wasyl07/skylark/buildroot-2025.02.15/board/freescale/imx6sxsdb/readme.txt

NXP i.MX6SX SDB board
---------------------

To build a minimal support for this board:

$ make imx6sx-sdb_defconfig
$ make

Buildroot prepares a bootable "sdcard.img" image in the output/images/
directory, ready to be flashed into the SD card:

$ sudo dd if=output/images/sdcard.img of=/dev/<sd-card-device>; sync

Then insert the SD card into the SD4 boot slot and boot the board.
