wasyl07/skylark/buildroot-2025.02.15/board/qemu/aarch64-virt/readme.txt

Run the emulation with:

  qemu-system-aarch64 -M virt -cpu cortex-a53 -nographic -smp 1 -kernel output/images/Image -append "rootwait root=/dev/vda console=ttyAMA0" -netdev user,id=eth0 -device virtio-net-device,netdev=eth0 -drive file=output/images/rootfs.ext4,if=none,format=raw,id=hd0 -device virtio-blk-device,drive=hd0 # qemu_aarch64_virt_defconfig

The login prompt will appear in the terminal that started Qemu.
