wasyl07/skylark/buildroot-2025.02.15/docs/manual/github_hash_mongrel2.png

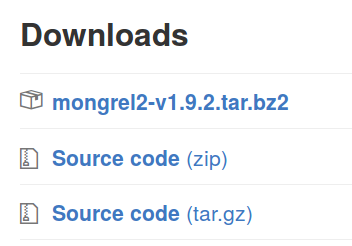
buildroot-2025.02.15/docs/manual/github_hash_mongrel2.png
