wasyl07/skylark/buildroot-2025.02.15/docs/website/images/buildroot-slides.png

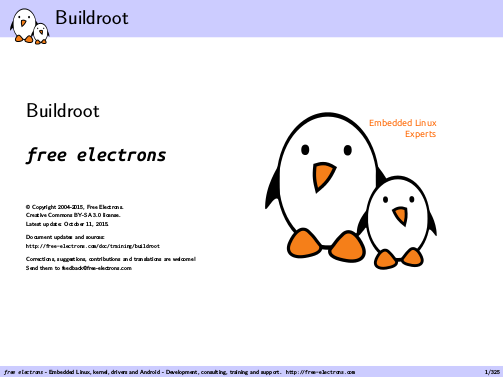
buildroot-2025.02.15/docs/website/images/buildroot-slides.png
