wasyl07/skylark/buildroot-2025.02.15/docs/website/images/menuconfig.png

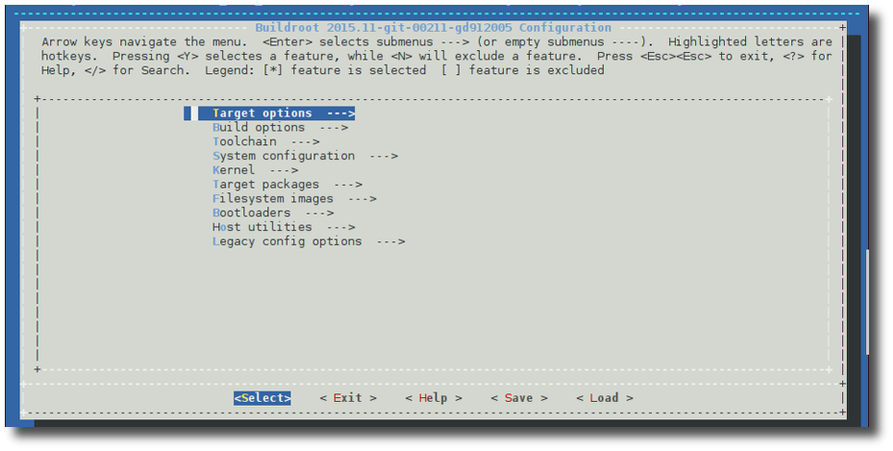
buildroot-2025.02.15/docs/website/images/menuconfig.png
