wasyl07/skylark/buildroot-2025.02.15/docs/website/images/nconfig.png

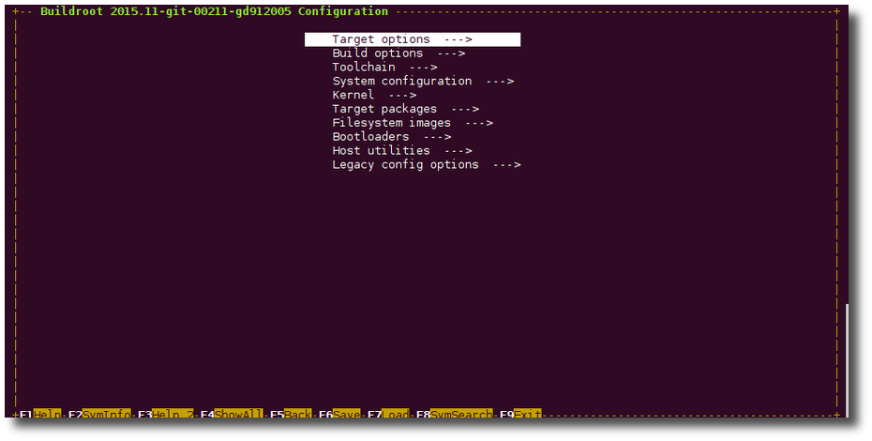
buildroot-2025.02.15/docs/website/images/nconfig.png
