wasyl07/skylark/BeagleBone-cape/BeagleBone-cape.kicad_pcb

## KiCad design BeagleBone-cape/BeagleBone-cape.kicad_pcb (2026-10-22)

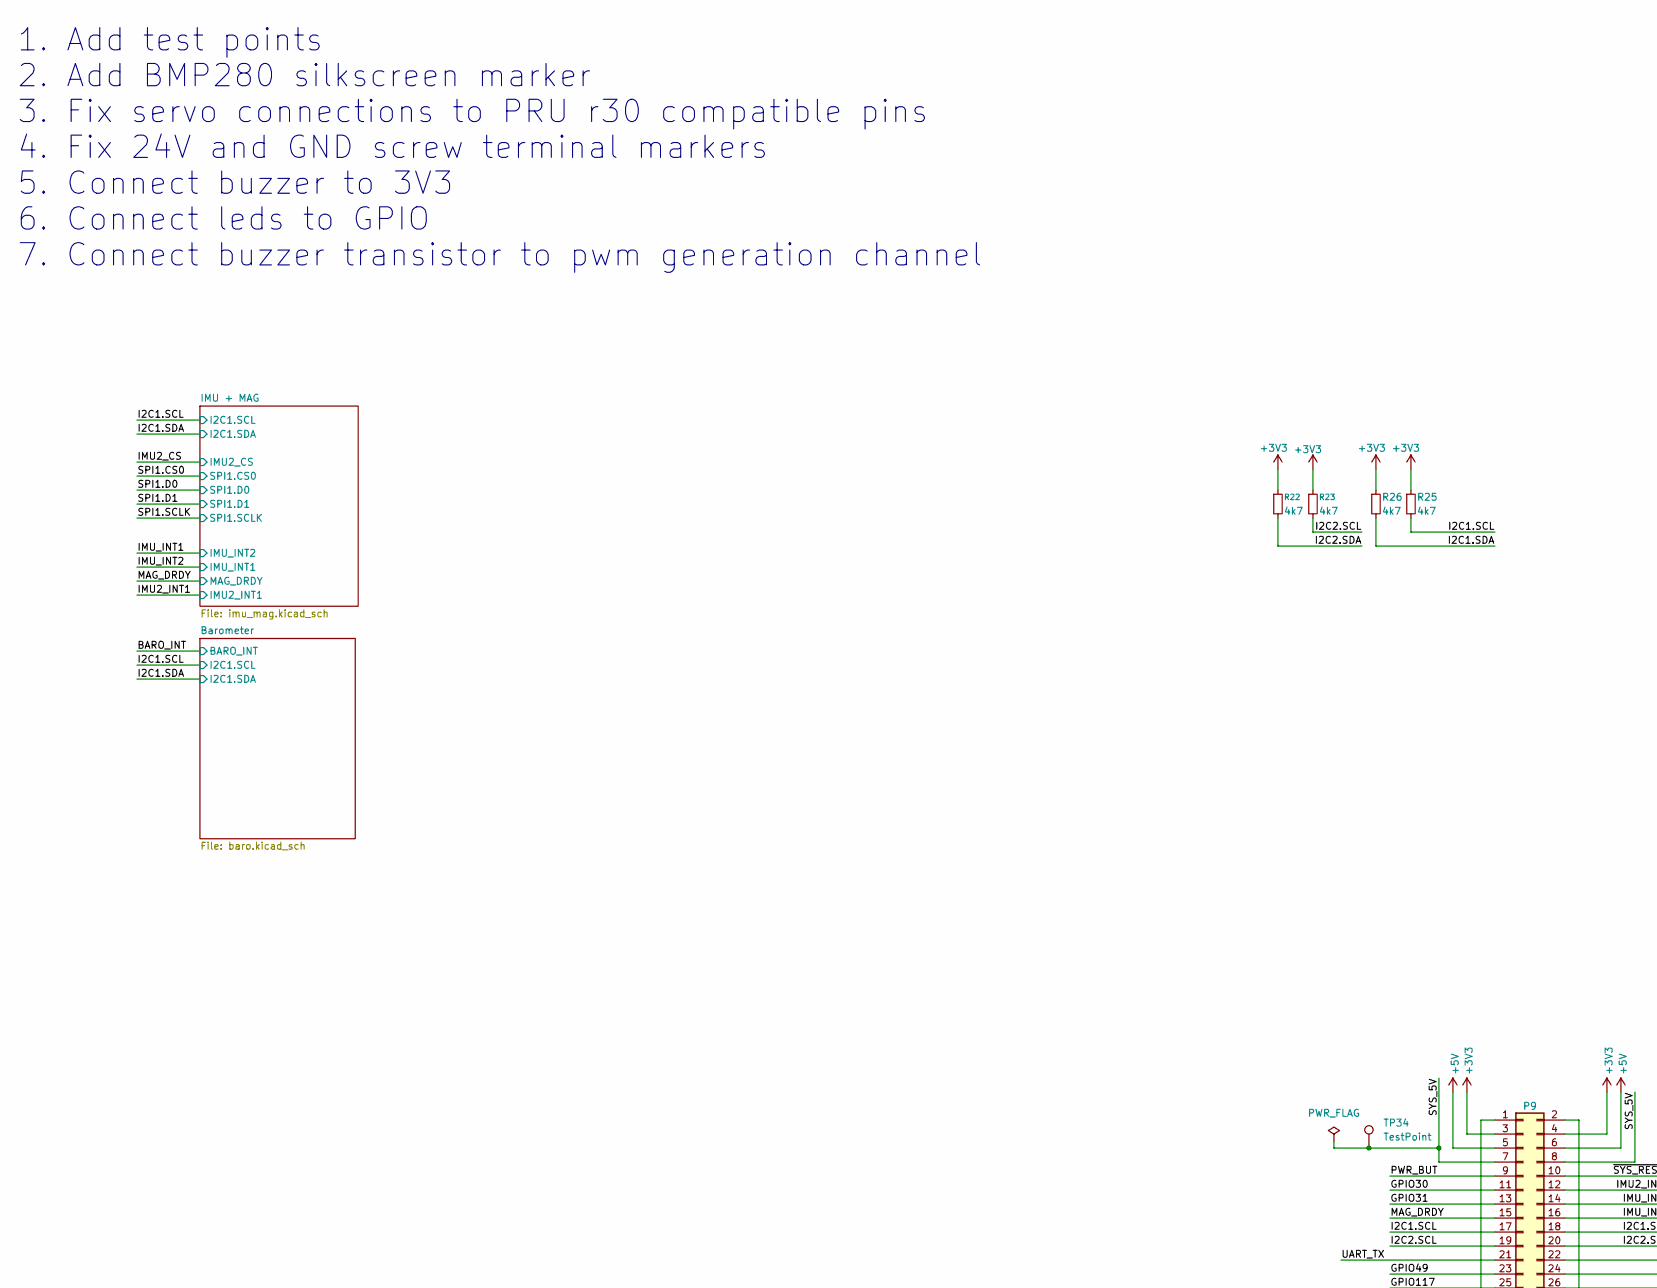
[picture p16: schematic BeagleBone-cape.kicad_sch, Skylark BeagleBone Black cape, part in row 1, column 1]

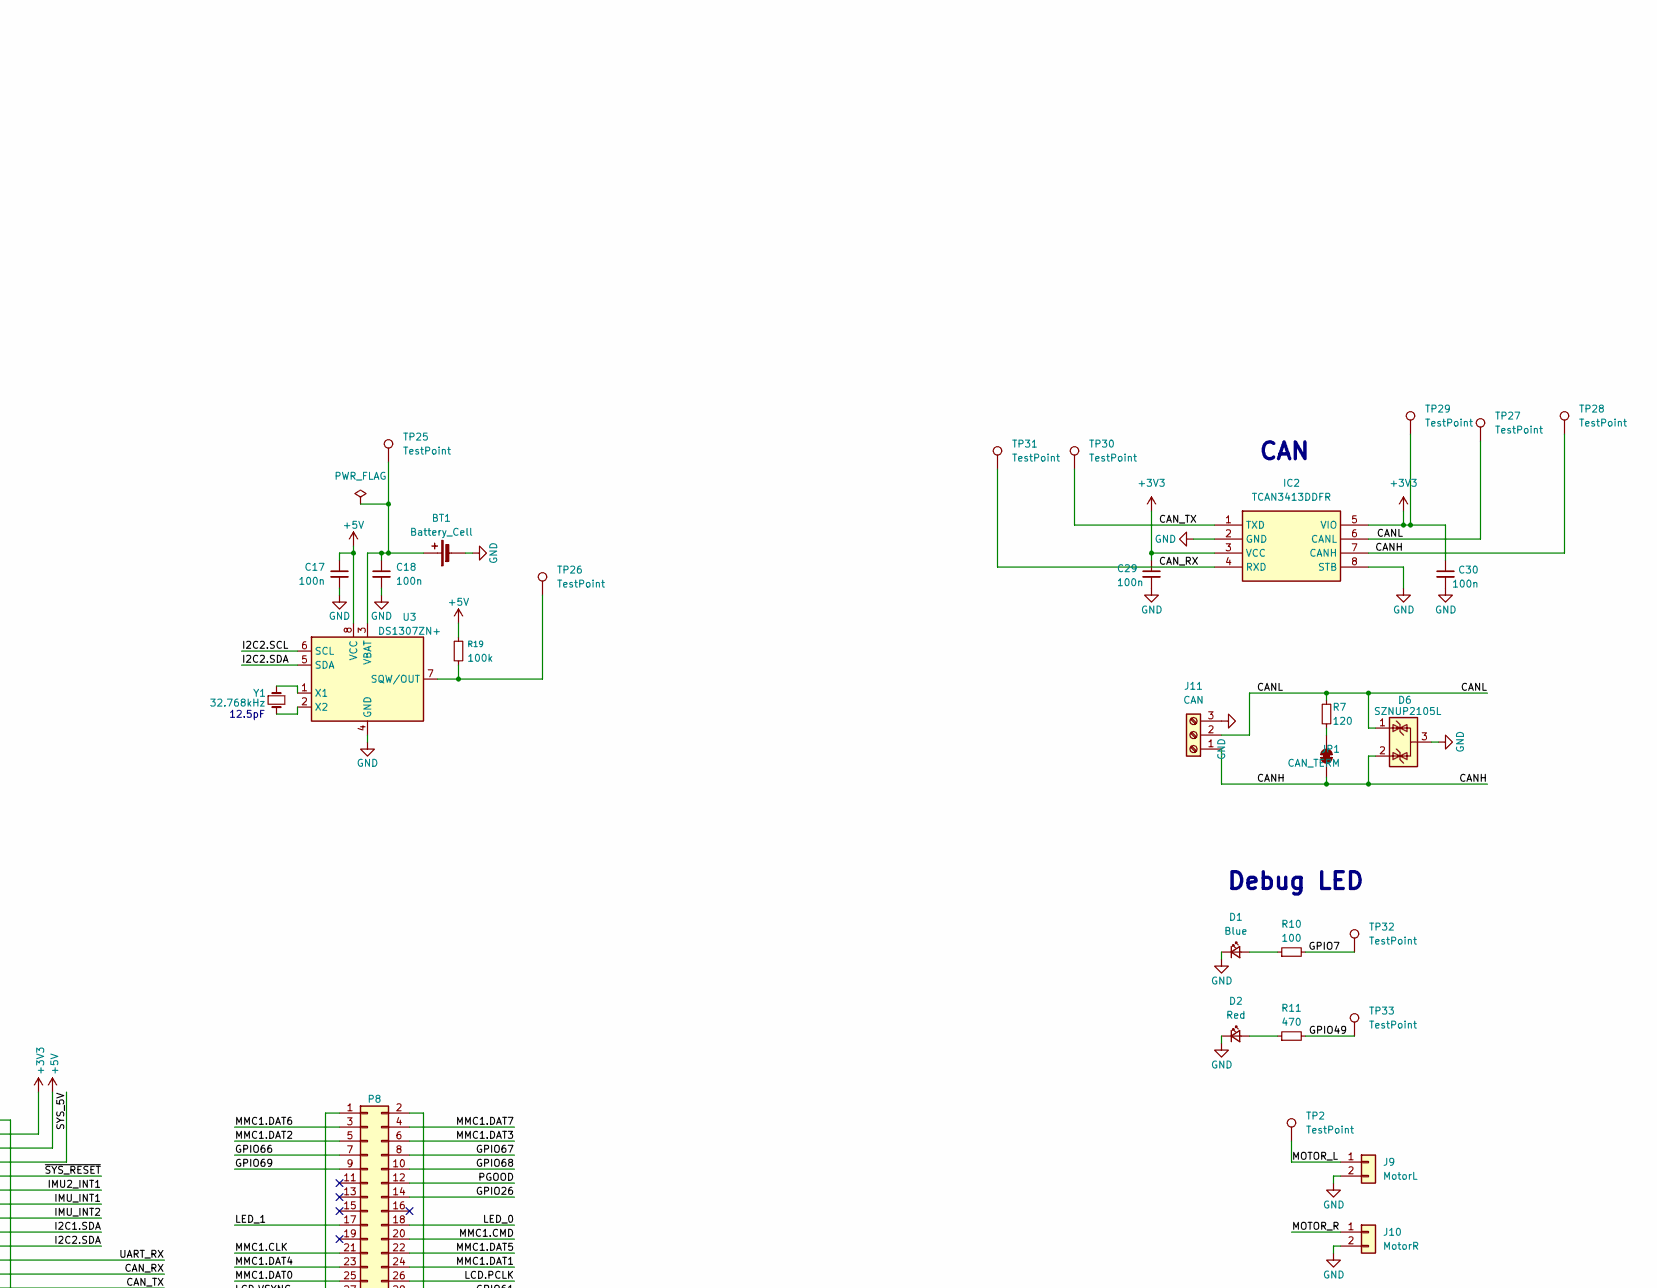
[picture p17: schematic BeagleBone-cape.kicad_sch, Skylark BeagleBone Black cape, part in row 1, column 2]

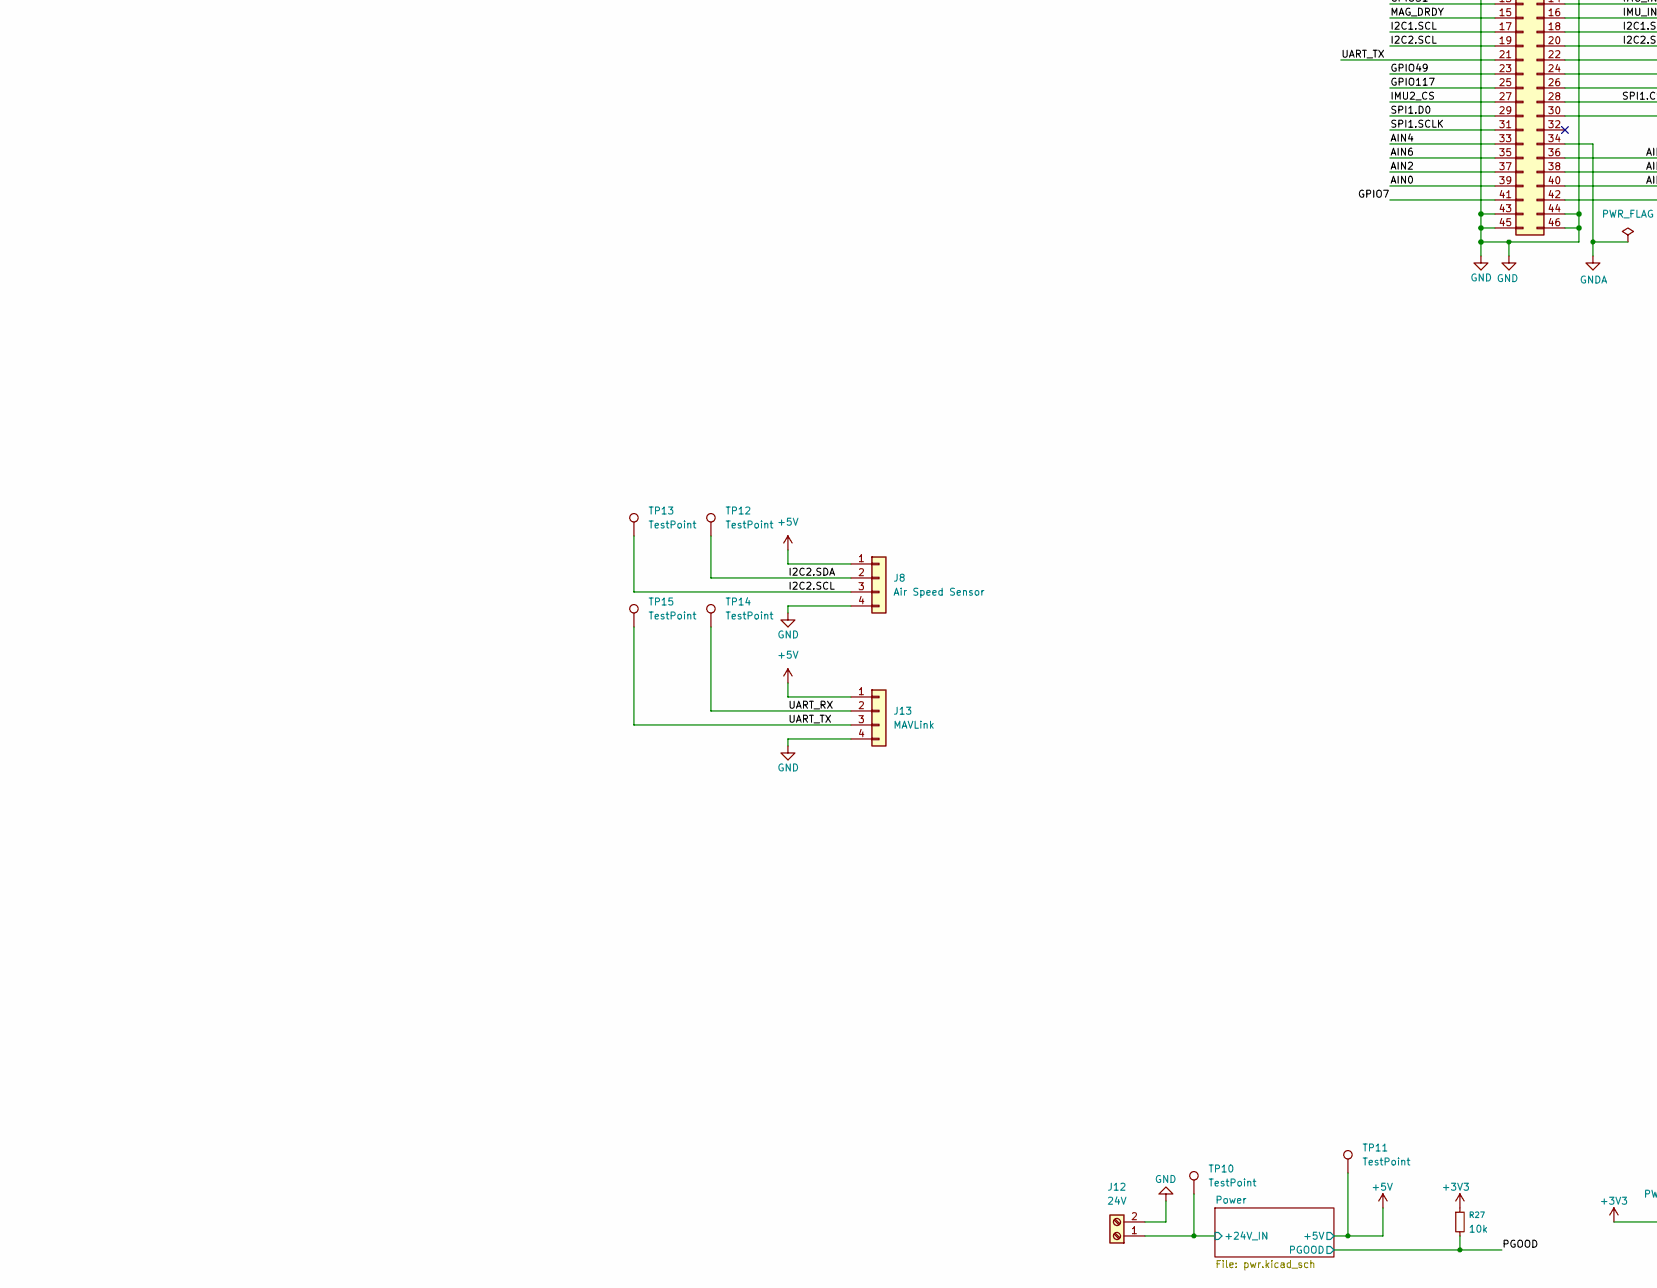
[picture p18: schematic BeagleBone-cape.kicad_sch, Skylark BeagleBone Black cape, part in row 2, column 1]

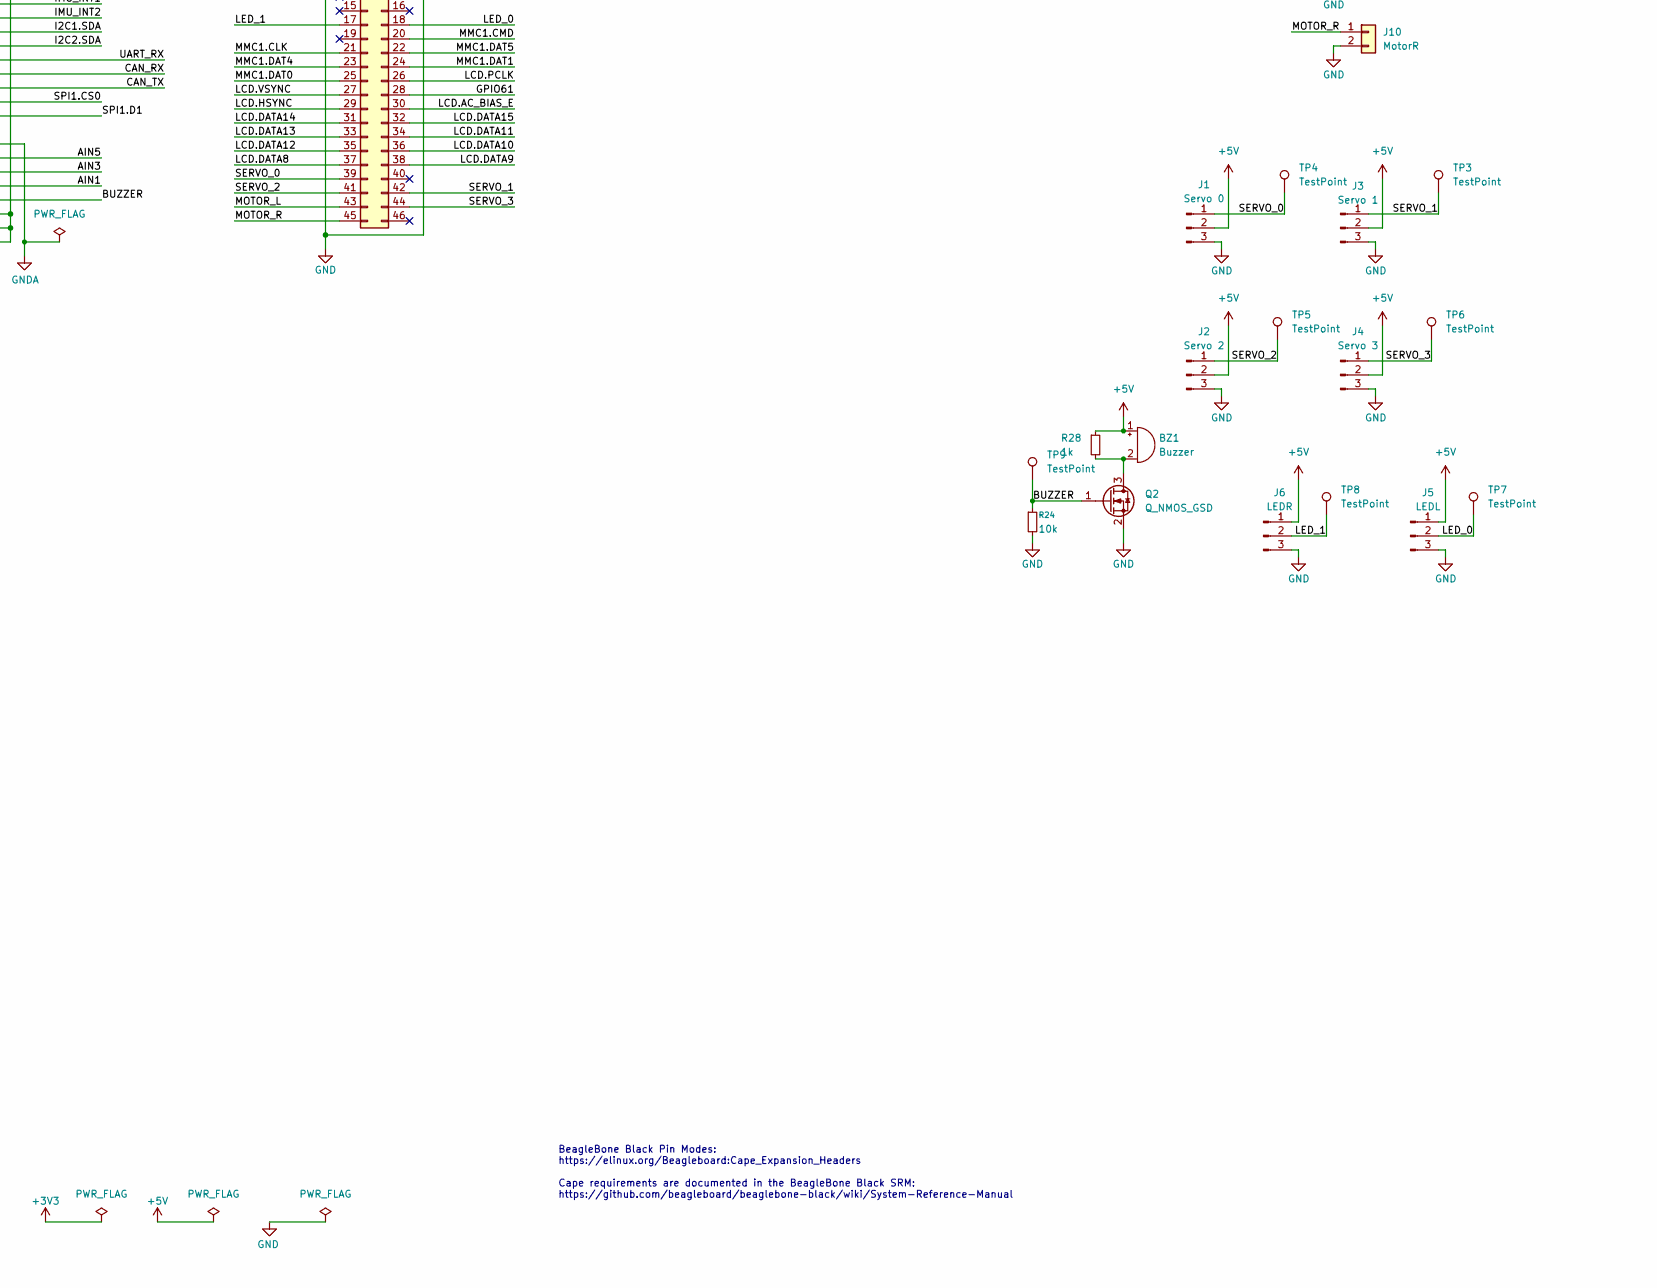
[picture p19: schematic BeagleBone-cape.kicad_sch, Skylark BeagleBone Black cape, part in row 2, column 2]

Parts:
BT1: Battery_Cell; BatteryHolder_MYOUNG_BS-07-A1BJ001_CR2032; Manufacturer_Part_Number BS-07-A1BJ001; LCSC C2979167
BZ1: Buzzer; Buzzer_TDK_PS1240P02BT_D12.2mm_H6.5mm; Manufacturer_Part_Number PS1240P02BT; LCSC C76871
C17, C18, C29, C30: 100n; C_0603_1608Metric_Pad1.08x0.95mm_HandSolder; Manufacturer_Part_Number CC0603KRX7R9BB104; LCSC C14663
D1: Blue; D_0603_1608Metric
D2: Red; D_0603_1608Metric
D6: SZNUP2105L; SOT-23; Manufacturer_Part_Number SZNUP2105LT1G; LCSC C233494
IC2: TCAN3413DDFR; SOT65P280X110-8N; Manufacturer_Part_Number TCAN3413DDFR; Mouser Part Number 595-TCAN3413DDFR
J1: Servo 0; JST_EH_B3B-EH-A_1x03_P2.50mm_Vertical
J2: Servo 2; JST_EH_B3B-EH-A_1x03_P2.50mm_Vertical
J3: Servo 1; JST_EH_B3B-EH-A_1x03_P2.50mm_Vertical
J4: Servo 3; JST_EH_B3B-EH-A_1x03_P2.50mm_Vertical
J5: LEDL; JST_EH_B3B-EH-A_1x03_P2.50mm_Vertical
J6: LEDR; JST_EH_B3B-EH-A_1x03_P2.50mm_Vertical
J8: Air Speed Sensor; JST_EH_B4B-EH-A_1x04_P2.50mm_Vertical
J9: MotorL; JST_EH_B2B-EH-A_1x02_P2.50mm_Vertical
J10: MotorR; JST_EH_B2B-EH-A_1x02_P2.50mm_Vertical
J11: CAN; TerminalBlock_Xinya_XY308-2.54-3P_1x03_P2.54mm_Horizontal
J12: 24V; TerminalBlock_Xinya_XY308-2.54-2P_1x02_P2.54mm_Horizontal
J13: MAVLink; JST_EH_B4B-EH-A_1x04_P2.50mm_Vertical
JP1: CAN_TERM; SolderJumper-2_P1.3mm_Bridged_RoundedPad1.0x1.5mm
P8, P9: BeagleBone_Black_Header; PinHeader_2x23_P2.54mm_Vertical
Q2: Q_NMOS_GSD; SOT-23; Manufacturer_Part_Number BSS138LT1G; LCSC C82045
R7: 120; R_0603_1608Metric_Pad0.98x0.95mm_HandSolder; Manufacturer_Part_Number 0603WAF1200T5E; LCSC C22787
R10: 100; R_0603_1608Metric_Pad0.98x0.95mm_HandSolder; Manufacturer_Part_Number RC0603FR-07100RL; LCSC C105588
R11: 470; R_0603_1608Metric_Pad0.98x0.95mm_HandSolder; Manufacturer_Part_Number 0603WAF4700T5E; LCSC C23179
R19: 100k; R_0603_1608Metric_Pad0.98x0.95mm_HandSolder; Manufacturer_Part_Number RC0603FR-07100KL; LCSC C14675
R22, R23: 4k7; R_0603_1608Metric_Pad0.98x0.95mm_HandSolder; Manufacturer_Part_Number RC0603FR-074K7L; LCSC C99782
R24, R27: 10k; R_0603_1608Metric_Pad0.98x0.95mm_HandSolder; Manufacturer_Part_Number RC0603FR-0710KL; LCSC C98220
R25, R26: 4k7; R_0603_1608Metric_Pad0.98x0.95mm_HandSolder
R28: 1k; R_0603_1608Metric_Pad0.98x0.95mm_HandSolder; Manufacturer_Part_Number 0603WAF1001T5E; LCSC C21190
TP2, TP3, TP4, TP5, TP6, TP7, TP8, TP9, TP10, TP11, TP12, TP13, TP14, TP15, TP25, TP26, TP27, TP28, TP29, TP30, TP31, TP32, TP33, TP34: TestPoint; TestPoint_Pad_D1.0mm
U3: DS1307ZN+; SOIC-8_3.9x4.9mm_P1.27mm; Manufacturer_Part_Number DS1307ZN+T&R; LCSC C26858
Y1: 32.768kHz; Crystal_SMD_3215-2Pin_3.2x1.5mm; Manufacturer_Part_Number Q13FC13500004; LCSC C32346

Connections:
+3V3: C29.1, C30.1, IC2.3 (VCC), IC2.5 (VIO), P9.3, P9.4, R22.1, R23.1, R25.1, R26.1, R27.1, TP29.1; also elsewhere on the board
+5V: BZ1.1 (+), C17.1, J1.2, J2.2, J3.2, J4.2, J5.1, J6.1, J8.1, J13.1, P9.5, P9.6, R19.1, R28.1, TP11.1, U3.8 (VCC); also elsewhere on the board
/AIN0: P9.39
/AIN1: P9.40
/AIN2: P9.37
/AIN3: P9.38
/AIN4: P9.33
/AIN5: P9.36
/AIN6: P9.35
/BUZZER: P9.42, Q2.1 (G), R24.1, TP9.1
/CANH: D6.2 (K), IC2.7 (CANH), J11.1, JP1.1 (A), TP28.1
/CANL: D6.1 (K), IC2.6 (CANL), J11.2, R7.1, TP27.1
/CAN_RX: IC2.4 (RXD), P9.24, TP31.1
/CAN_TX: IC2.1 (TXD), P9.26, TP30.1
/GPIO7: P9.41, R10.2, TP32.1
/GPIO26: P8.14
/GPIO30: P9.11
/GPIO31: P9.13
/GPIO49: P9.23, R11.2, TP33.1
/GPIO61: P8.28
/GPIO66: P8.7
/GPIO67: P8.8
/GPIO68: P8.10
/GPIO69: P8.9
/GPIO117: P9.25
/I2C1.SCL: P9.17, R25.2; also elsewhere on the board
/I2C1.SDA: P9.18, R26.2; also elsewhere on the board
/I2C2.SCL: J8.3, P9.19, R23.2, TP13.1, U3.6 (SCL)
/I2C2.SDA: J8.2, P9.20, R22.2, TP12.1, U3.5 (SDA)
/IMU2_CS: P9.27; also elsewhere on the board
/IMU2_INT1: P9.12; also elsewhere on the board
/IMU_INT1: P9.14; also elsewhere on the board
/IMU_INT2: P9.16; also elsewhere on the board
/LCD.AC_BIAS_E: P8.30
/LCD.DATA8: P8.37
/LCD.DATA9: P8.38
/LCD.DATA10: P8.36
/LCD.DATA11: P8.34
/LCD.DATA12: P8.35
/LCD.DATA13: P8.33
/LCD.DATA14: P8.31
/LCD.DATA15: P8.32
/LCD.HSYNC: P8.29
/LCD.PCLK: P8.26
/LCD.VSYNC: P8.27
/LED_0: J5.2, P8.18, TP7.1
/LED_1: J6.2, P8.17, TP8.1
/MAG_DRDY: P9.15; also elsewhere on the board
/MMC1.CLK: P8.21
/MMC1.CMD: P8.20
/MMC1.DAT0: P8.25
/MMC1.DAT1: P8.24
/MMC1.DAT2: P8.5
/MMC1.DAT3: P8.6
/MMC1.DAT4: P8.23
/MMC1.DAT5: P8.22
/MMC1.DAT6: P8.3
/MMC1.DAT7: P8.4
/MOTOR_L: J9.1, P8.43, TP2.1
/MOTOR_R: J10.1, P8.45
/PGOOD: P8.12, R27.2; also elsewhere on the board
/PWR_BUT: P9.9
/Power/+24V_IN: J12.1, TP10.1; also elsewhere on the board
/SERVO_0: J1.1, P8.39, TP4.1
/SERVO_1: J3.1, P8.42, TP3.1
/SERVO_2: J2.1, P8.41, TP5.1
/SERVO_3: J4.1, P8.44, TP6.1
/SPI1.CS0: P9.28; also elsewhere on the board
/SPI1.D0: P9.29; also elsewhere on the board
/SPI1.D1: P9.30; also elsewhere on the board
/SPI1.SCLK: P9.31; also elsewhere on the board
/SYS_5V: P9.7, P9.8, TP34.1
/UART_RX: J13.2, P9.22, TP14.1
/UART_TX: J13.3, P9.21, TP15.1
/~SYS_RESET: P9.10
GND: BT1.2 (-), C17.2, C18.2, C29.2, C30.2, D1.1 (K), D2.1 (K), D6.3 (A), IC2.2 (GND), IC2.8 (STB), J1.3, J2.3, J3.3, J4.3, J5.3, J6.3, J8.4, J9.2, J10.2, J11.3, J12.2, J13.4, P8.1, P8.2, P9.1, P9.2, P9.43, P9.44, P9.45, P9.46, Q2.2 (S), R24.2, U3.4 (GND); also elsewhere on the board
GNDA: P9.34
unnamed: BT1.1 (+), C18.1, TP25.1, U3.3 (VBAT)
unnamed: BZ1.2 (-), Q2.3 (D), R28.2
unnamed: D1.2 (A), R10.1
unnamed: D2.2 (A), R11.1
unnamed: JP1.2 (B), R7.2
unnamed: R19.2, TP26.1, U3.7 (SQW/OUT)
unnamed: U3.1 (X1), Y1.1
unnamed: U3.2 (X2), Y1.2

Notes on the sheet:
CAN
BeagleBone Black Pin Modes: https://elinux.org/Beagleboard:Cape_Expansion_Headers Cape requirements are documented in the BeagleBone Black SRM: https://github.com/beagleboard/beaglebone-black/wiki/System-Reference-Manual
1. Add test points 2. Add BMP280 silkscreen marker 3. Fix servo connections to PRU r30 compatible pins 4. Fix 24V and GND screw terminal markers 5. Connect buzzer to 3V3 6. Connect leds to GPIO 7. Connect buzzer transistor to pwm generation channel
Debug LED
12.5pF

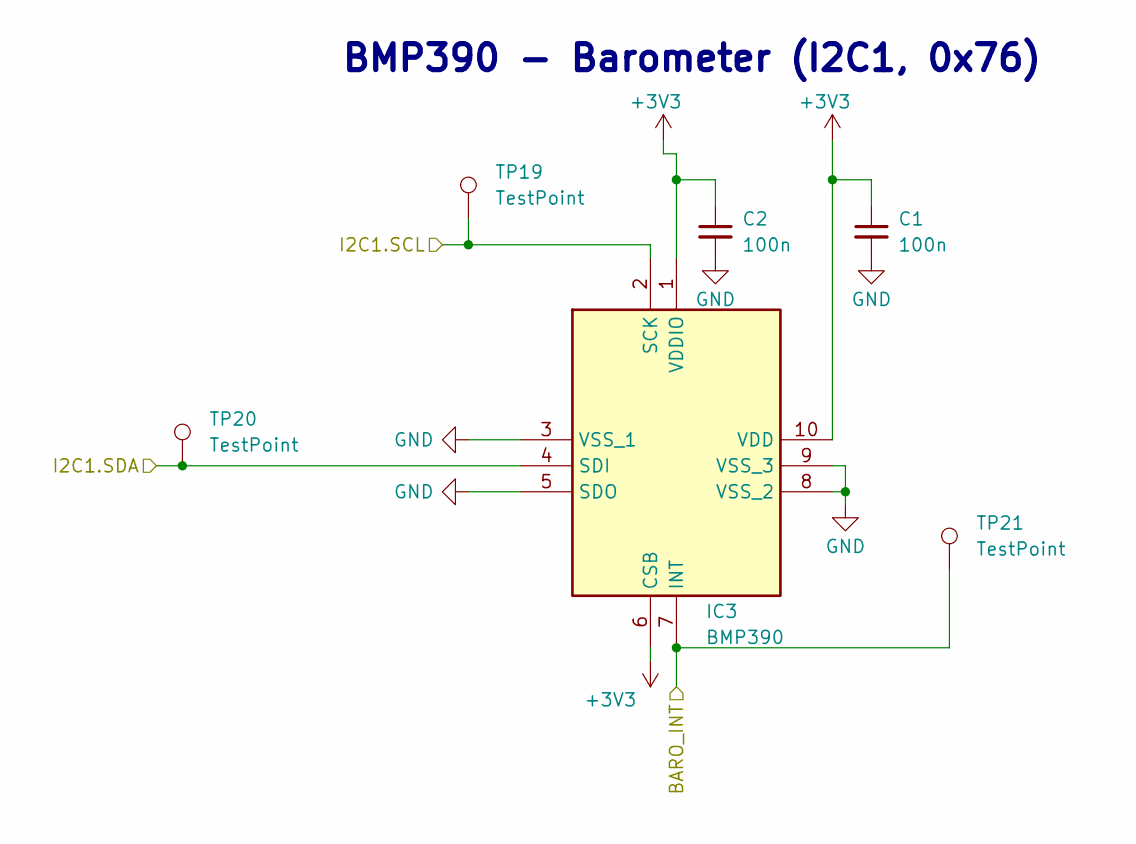
[picture p20: schematic baro.kicad_sch]

Parts:
C1, C2: 100n; C_0603_1608Metric_Pad1.08x0.95mm_HandSolder; Manufacturer_Part_Number CC0603KRX7R9BB104; LCSC C14663
IC3: BMP390; Manufacturer_Part_Number BMP390; Mouser Part Number 262-BMP390
TP19, TP20, TP21: TestPoint; TestPoint_Pad_D1.0mm

Connections:
+3V3: C1.1, C2.1, IC3.1 (VDDIO), IC3.6 (CSB), IC3.10 (VDD); also elsewhere on the board
/BARO_INT: IC3.7 (INT), TP21.1
/I2C1.SCL: IC3.2 (SCK), TP19.1; also elsewhere on the board
/I2C1.SDA: IC3.4 (SDI), TP20.1; also elsewhere on the board
GND: C1.2, C2.2, IC3.3 (VSS_1), IC3.5 (SDO), IC3.8 (VSS_2), IC3.9 (VSS_3); also elsewhere on the board

Notes on the sheet:
BMP390 - Barometer (I2C1, 0x76)

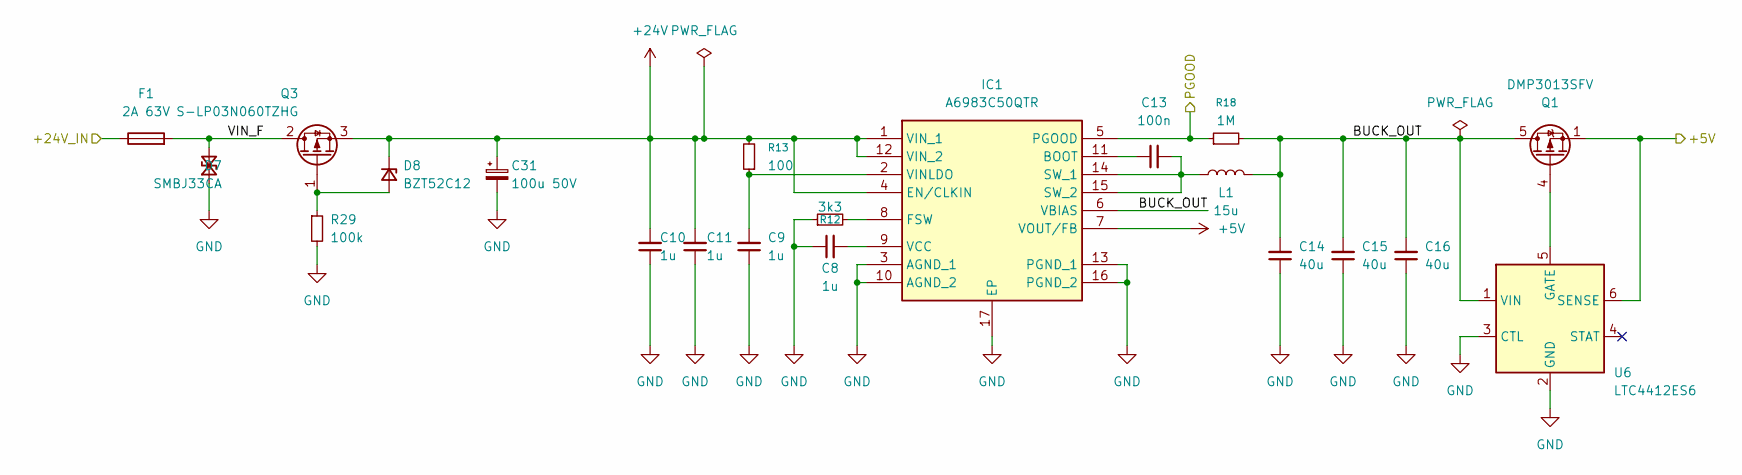
[picture p21: schematic pwr.kicad_sch, Skylark BeagleBone Black cape - power]

Parts:
C8, C9, C10, C11: 1u; C_0603_1608Metric_Pad1.08x0.95mm_HandSolder; Manufacturer_Part_Number CL10A105KB8NNNC; LCSC C15849
C13: 100n; C_0603_1608Metric_Pad1.08x0.95mm_HandSolder; Manufacturer_Part_Number CC0603KRX7R9BB104; LCSC C14663
C14, C15, C16: 40u; C_Elec_5x5.4; Manufacturer_Part_Number EFVM016ADA470M0545; LCSC C48935064
C31: 100u 50V; CP_Elec_8x10; Manufacturer_Part_Number EEE-FK1H101P; LCSC C178548
D7: SMBJ33CA; D_SMB; Manufacturer_Part_Number SMBJ33CA; LCSC C78420
D8: BZT52C12; D_SOD-123; Manufacturer_Part_Number BZT52C12-TP; LCSC C668891
F1: 2A 63V; Fuse_1206_3216Metric_Pad1.42x1.75mm_HandSolder; Manufacturer_Part_Number 0466002.NRHF; LCSC C3105
IC1: A6983C50QTR; Manufacturer_Part_Number A6983C50QTR; Mouser Part Number 511-A6983C50QTR
L1: 15u; L_7.3x7.3_H4.5; Manufacturer_Part_Number SDRH.0704CT.NLF150MT00; LCSC C5123035
Q1: DMP3013SFV; Diodes_PowerDI3333-8
Q3: S-LP03N060TZHG; SOT-223-3_TabPin2; Manufacturer_Part_Number S-LP03N060TZHG; LCSC C5200150
R12: 3k3; R_0603_1608Metric_Pad0.98x0.95mm_HandSolder; Manufacturer_Part_Number 0603WAF3301T5E; LCSC C22978
R13: 100; R_0603_1608Metric_Pad0.98x0.95mm_HandSolder; Manufacturer_Part_Number RC0603FR-07100RL; LCSC C105588
R18: 1M; R_0603_1608Metric_Pad0.98x0.95mm_HandSolder; Manufacturer_Part_Number RC0603FR-071ML; LCSC C105578
R29: 100k; R_0603_1608Metric_Pad0.98x0.95mm_HandSolder; Manufacturer_Part_Number RC0603FR-07100KL; LCSC C14675
U6: LTC4412ES6; TSOT-23-6

Connections:
+5V: IC1.7 (VOUT/FB), Q1.1 (S), Q1.2 (S), Q1.3 (S), U6.6 (SENSE); also elsewhere on the board
+24V: C10.2, C11.2, C31.1, D8.1 (K), IC1.1 (VIN_1), IC1.4 (EN/CLKIN), IC1.12 (VIN_2), Q3.3 (S), R13.2
/PGOOD: IC1.5 (PGOOD), R18.1; also elsewhere on the board
/Power/+24V_IN: F1.1; also elsewhere on the board
/Power/BUCK_OUT: C14.2, C15.2, C16.2, IC1.6 (VBIAS), L1.2, Q1.5 (D), R18.2, U6.1 (VIN)
/Power/VIN_F: D7.2 (A2), F1.2, Q3.2 (D)
GND: C8.1, C9.1, C10.1, C11.1, C14.1, C15.1, C16.1, C31.2, D7.1 (A1), IC1.3 (AGND_1), IC1.10 (AGND_2), IC1.13 (PGND_1), IC1.16 (PGND_2), IC1.17 (EP), R12.1, R29.2, U6.2 (GND), U6.3 (CTL); also elsewhere on the board
unnamed: D8.2 (A), Q3.1 (G), R29.1
unnamed: C13.1, IC1.11 (BOOT)
unnamed: IC1.8 (FSW), R12.2
unnamed: C13.2, IC1.14 (SW_1), IC1.15 (SW_2), L1.1
unnamed: C8.2, IC1.9 (VCC)
unnamed: C9.2, IC1.2 (VINLDO), R13.1
unnamed: Q1.4 (G), U6.5 (GATE)

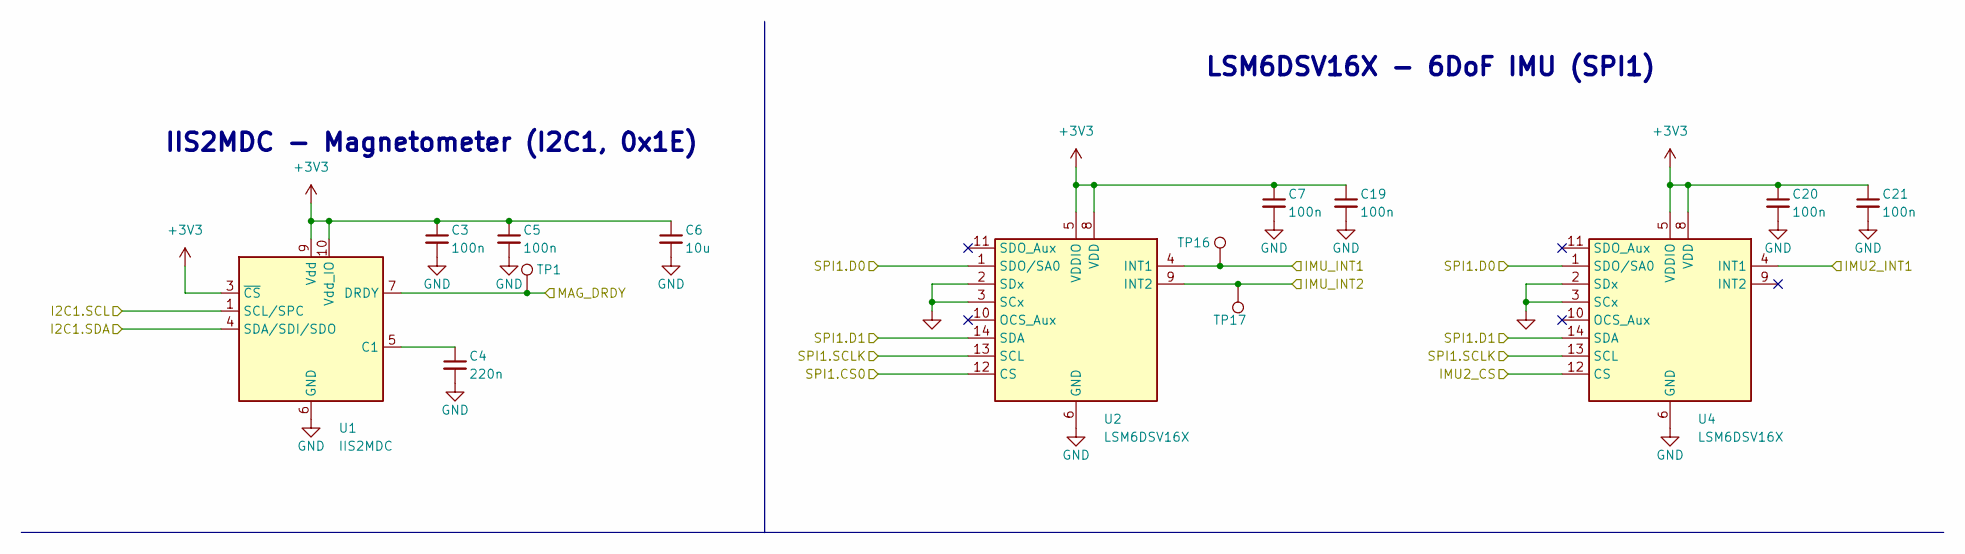
[picture p22: schematic imu_mag.kicad_sch]

Parts:
C3, C5, C7, C19, C20, C21: 100n; C_0603_1608Metric_Pad1.08x0.95mm_HandSolder; Manufacturer_Part_Number CC0603KRX7R9BB104; LCSC C14663
C4: 220n; C_0603_1608Metric_Pad1.08x0.95mm_HandSolder; Part number 220n-50V-X7R-10%; LCSC C6119835
C6: 10u; C_0603_1608Metric_Pad1.08x0.95mm_HandSolder; Manufacturer_Part_Number CL10A106KP8NNNC; LCSC C19702
TP1, TP16, TP17: TestPoint; TestPoint_Pad_D1.0mm
U1: IIS2MDC; LGA-12_2x2mm_P0.5mm; Manufacturer_Part_Number IIS2MDCTR
U2, U4: LSM6DSV16X; LGA-14_3x2.5mm_P0.5mm_LayoutBorder3x4y; Manufacturer_Part_Number LSM6DSV16XTR

Connections:
+3V3: C3.1, C5.1, C6.1, C7.1, C19.1, C20.1, C21.1, U1.3 (~CS), U1.9 (Vdd), U1.10 (Vdd_IO), U2.5 (VDDIO), U2.8 (VDD), U4.5 (VDDIO), U4.8 (VDD); also elsewhere on the board
/I2C1.SCL: U1.1 (SCL/SPC); also elsewhere on the board
/I2C1.SDA: U1.4 (SDA/SDI/SDO); also elsewhere on the board
/IMU2_CS: U4.12 (CS); also elsewhere on the board
/IMU2_INT1: U4.4 (INT1); also elsewhere on the board
/IMU_INT1: TP17.1, U2.9 (INT2); also elsewhere on the board
/IMU_INT2: TP16.1, U2.4 (INT1); also elsewhere on the board
/MAG_DRDY: TP1.1, U1.7 (DRDY); also elsewhere on the board
/SPI1.CS0: U2.12 (CS); also elsewhere on the board
/SPI1.D0: U2.1 (SDO/SA0), U4.1 (SDO/SA0); also elsewhere on the board
/SPI1.D1: U2.14 (SDA), U4.14 (SDA); also elsewhere on the board
/SPI1.SCLK: U2.13 (SCL), U4.13 (SCL); also elsewhere on the board
GND: C3.2, C4.2, C5.2, C6.2, C7.2, C19.2, C20.2, C21.2, U1.6 (GND), U1.8 (GND), U2.2 (SDx), U2.3 (SCx), U2.6 (GND), U2.7 (GND), U4.2 (SDx), U4.3 (SCx), U4.6 (GND), U4.7 (GND); also elsewhere on the board
unnamed: C4.1, U1.5 (C1)

Notes on the sheet:
LSM6DSV16X - 6DoF IMU (SPI1)
IIS2MDC - Magnetometer (I2C1, 0x1E)

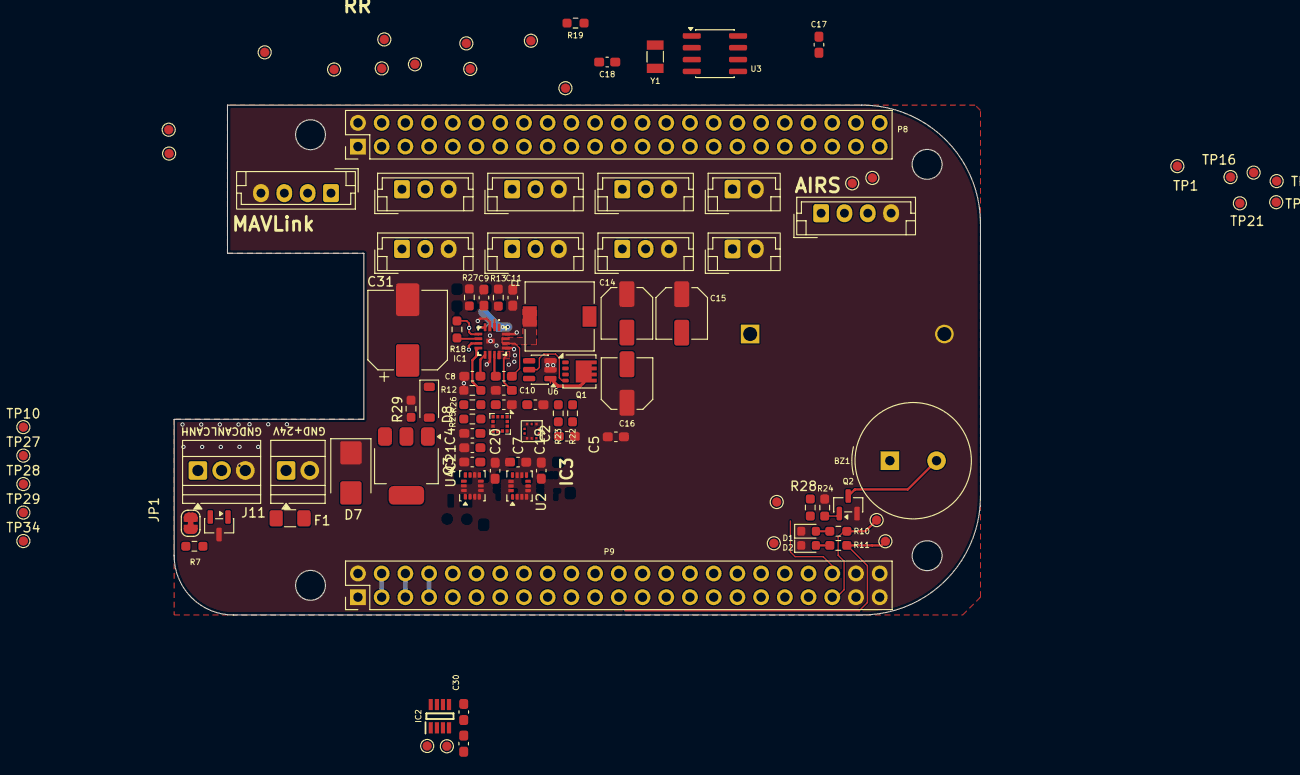
[picture p23: board BeagleBone-cape.kicad_pcb from above]

Board: 4 copper layers, 86.4 x 54.6 mm, 108 parts (1 on the bottom side), 56 nets.

Other parts of the board:
MH1, MH2, MH3, MH4: MountingHole_3.2mm_M3_DIN965
