wasyl07/skylark/(commit log)

2026-06-28 Add cape project
    [BeagleBone-cape.kicad_pcb, BeagleBone-cape.kicad_sch, bom.csv, bom2.csv, designators.csv, positions.csv, pwr.kicad_sch]
2026-06-28 Add buildroot project
    [config_0w.txt, config_3.txt, config_3_64bit.txt, config_3_qt5we.txt, config_4.txt, config_4_64bit.txt, config_5.txt, config_cm4io.txt]
2026-10-03 Add br2-skylark BR2_EXTERNAL tree for A/B SD card image
    - skylark_bbb_defconfig: BBB, bb.org 6.6.58-ti kernel, U-Boot 2025.01,
    systemd, RAUC, Bootlin glibc toolchain
    - MBR layout: boot FAT 64M, rootfs A/B 512M ext4, data (grown on first boot)
    - U-Boot A/B bootchooser script, redundant env on raw MMC
    - RAUC system.conf, verity bundle + MANIFEST.json in post-image
    - skylark-config package: /data mount, growdata, firstboot, factory reset,
    rauc-mark-good
    - Top-level Makefile wrapper (O=output), verify-image/check-defconfig scripts
    [genimage.cfg]
2026-10-05 buildroot: move boot console to UART4 (P9.11/P9.13)
    SPL and U-Boot use CONFIG_CONS_INDEX=5 via a config fragment; U-Boot DT
    stdout-path points to uart4. uEnv.txt console set to ttyS4.
2026-10-05 buildroot: overlay with UART4 and DS1307, install freshly built overlay
    - skylark-overlay.dts: enable uart4 with pinmux, declare DS1307 RTC on
    i2c2 @0x68, fix CAN1 pin comments (P9.24/P9.26, pull-up)
    - post-build.sh: install the overlay compiled by the kernel build instead
    of a stale prebuilt skylark-overlay.dtbo (renamed to .stale)
2026-10-05 buildroot: boot by PARTUUID so the image works from SD and eMMC
    genimage writes a fixed MBR disk signature (0x534b594c) and extlinux
    uses root=PARTUUID=534b594c-02. extlinux also applies
    skylark-overlay.dtbo and uses console=ttyS4.
    [genimage.cfg]
2026-10-05 buildroot: update beaglebone_defconfig with Skylark settings
    Adds rootfs overlay, custom DTS dir and overlay support, CAN/I2C tools,
    SSH, and the U-Boot and BusyBox config fragments.
2026-10-05 br2-skylark: console on UART4, accept legacy boot.scr, safe overlay apply
    - SPL/U-Boot/kernel/getty console on UART4 (P9.11/P9.13), the only free UART on the cape
    - CONFIG_LEGACY_IMAGE_FORMAT=y: FIT_SIGNATURE turns it off, U-Boot then refused
    boot.scr ('Wrong image format for source command') and fell back to distro boot
    - reload the plain DTB if the cape overlay fails to apply
2026-10-05 br2-skylark: cape overlay from tested board (UART4, CAN1, DS1307)
2026-10-05 skylark-config: networkd (DHCP+mDNS, can0 1 Mbit/s), persistent SSH, RAUC status on /data
    - eth0 DHCP + skylark.local, can0 at 1 Mbit/s with bus-off restart and qlen 100
    - SSH host keys and authorized_keys on /data: same keys on both slots
    - RAUC central status file /data/rauc.status
    - growdata: udevadm settle after resizing, otherwise data.mount was stopped
    again a few seconds after boot
2026-10-05 skylark-config: DS1307 RTC restore at boot, NTP->RTC sync via timesyncd
    skylark-rtc-restore sets the clock from the DS1307 before time-set.target
    (never backwards) and saves NTP time at shutdown; a 10 min timer rewrites the
    RTC when NTP is synchronized and it drifted > MAX_DRIFT (/etc/skylark/rtc.conf).
    I2C accesses are retried (first read after boot can time out).
2026-10-05 docs: A/B image is primary; legacy single-slot doc kept as fallback
2026-10-07 docs: bring-up record, cape rev 1 issues, development pitfalls
    - docs/bringup-2026-10-05.md: test results against FUNCTIONS.md, cape rev 1
    hardware issues (DS1307, 5 V I2C2 pull-ups, EEPROM), software fixes, board state
    - buildroot.md: development notes/pitfalls, recovery via SysRq, links
    - FUNCTIONS.md, README: link the record
2026-10-07 Add i2c logic level translator
    [BeagleBone-cape.kicad_pcb, BeagleBone-cape.kicad_sch, pwr.kicad_sch]
2026-10-07 Ignore kicad backups
2026-10-07 Update BeagleBone cape schematic/PCB, drop tracked KiCad backups
    [BeagleBone-cape.kicad_pcb, BeagleBone-cape.kicad_sch, pwr.kicad_sch]
2026-10-10 BeagleBone cape: add SN74LVC1T45 level shifters for BHI360 INT/RESET
    BHI360 is a 1.8 V device (VDDIO max 1.89 V, abs max VDDIO+0.3 V), while
    the AM335x P9 header is 3.3 V LVCMOS. Route INT (U2.4 -> P9.14) through
    U7 (A->B, DIR=+1V8) and RESETN (P9.16 -> U2.17) through U8 (B->A,
    DIR=GND). R28 10k holds RESET deasserted on the 3.3 V side while the pin
    is undriven; C40-C43 decouple both sides.
    PCB not yet updated from schematic; new parts still need placement and
    routing. Some new parts sit off the 1.27 mm grid.
2026-10-10 BeagleBone cape: update KiCad project view state (.kicad_prl)
2026-10-10 Ignore KiCad lock files (~*.lck)
2026-10-10 Stop tracking KiCad backups; ignore backup archives
    Untrack the BeagleBone-cape-backups zips, production/backups zips and
    the .bak / kicad_sch-bak copies. Files stay on disk. .gitignore covers
    *backups/, *.bak and *-bak.
2026-10-12 BeagleBone cape: PCB/schematic updates, cape issues list, docs
    - Update BeagleBone-cape KiCad schematic and PCB; add BHI360/BMP390 footprint updates
    - Add ISSUES.md: cape design review findings (BHI360 1.8V/3.3V level shifting, etc.)
    - Ignore .kicad-mcp/ local state
    - Update docs/ROADMAP.md and docs/prus.md (PRU1 servo/ESC PWM design); README link
2026-10-12 Cape: replace BHI360/BMM350 with LSM6DSV16X (SPI1) + IIS2MDC (I2C1)
    - Remove BHI360, BMM350 and the 1.8 V domain (TLV75518, PCA9306, SN74LVC1T45 x2)
    - Add LSM6DSV16X on SPI1 (P9.28-31), INT1/INT2 on P9.14/P9.16
    - Add IIS2MDC on I2C1 (0x1E), DRDY on P9.15; BMP390 moved to 3.3 V on I2C1
    - Move LED1 feed from P9.30 to P9.23 (P9.30 is now SPI1 D1)
    - PCB: drop removed footprints and orphaned copper; new parts staged, not routed
    - ISSUES.md: full cape review (issues 21-38); FUNCTIONS.md hardware mapping
2026-10-18 Cape: finish IMU/baro schematic, PCB sync and cleanup
    Schematic:
    - remove cape EEPROM U1, SW1, TP1 (#4)
    - PGOOD to P8.12 via 10k pull-up R27 (#10)
    - PWR_FLAGs on root, VBUS renamed SYS_5V, GPIO2/3 renamed UART_RX/TX (#6, #12, #33)
    - VBIAS of A6983 to BUCK_OUT (#34)
    - BMP390 symbol moved to Cape_lib, MPN fixed BMP388 -> BMP390 (#13)
    - LSM6DSV16X/IIS2MDC: add C49 10 uF decoupling, fix C48 value/MPN (datasheet audit)
    PCB:
    - sync from schematic, place U9, U10, C44-C49, R27
    - remove stray IMU-area +3V3/IMU_INT1 copper, old +3V3 In2 pour, dangling copper (#17, #18)
    - design rules: outer track 0.10 mm, edge clearance 0.3 mm, zone clearance 0.2 mm (#37)
    Routing is not done: 46 unconnected pads rem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
2026-10-18 Cape PCB: manual layout changes saved in KiCad after 536a2f9b
    Parts repositioned in KiCad (e.g. C49 at 163.42, 77.94). DRC on this state:
    83 violations, 52 unconnected pads (routing still to do).
2026-10-18 ISSUES: update cape issue status after schematic/PCB pass; commit KiCad prl
2026-10-22 Cape: add baro and IMU/mag schematic sheets, sync root/PCB/project files
2026-10-22 PCB: remove dangling +24V vias and SPI1.SCLK stubs; ISSUES: DRC status update
2026-10-22 Cape: unify CAN/FDCAN net names in schematic; ISSUES: ERC/DRC status update
2026-10-22 Cape schematic: input protection, buzzer fix, CAN GND/jumper, LCSC field, lib refresh; ISSUES rewrite
2026-10-22 WIP: Q3 -> S-LP03N060TZHG (SOT-223), PCB synced with new schematic parts, not yet routed (DRC: shorts, 200 unconnected)
2026-10-22 WIP: snap servo/LED/motor connectors to 4x2 grid, further PCB and pwr sheet edits
